prevedel-embl/ECG-gating/FPGA/Original codes/Matlab/index.jpg

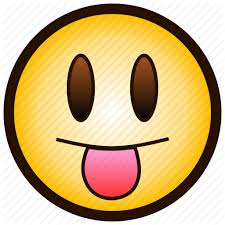
FPGA/Original codes/Matlab/index.jpg
