prevedel-embl/ECG-gating/FPGA/Demonstration/readme.txt

This is a demo file which can be copied into a microSD card for FPGA.
