prevedel-embl/ECG-gating/FPGA/pdf/Schematic of FPGA-board based ECG-gating system.pdf

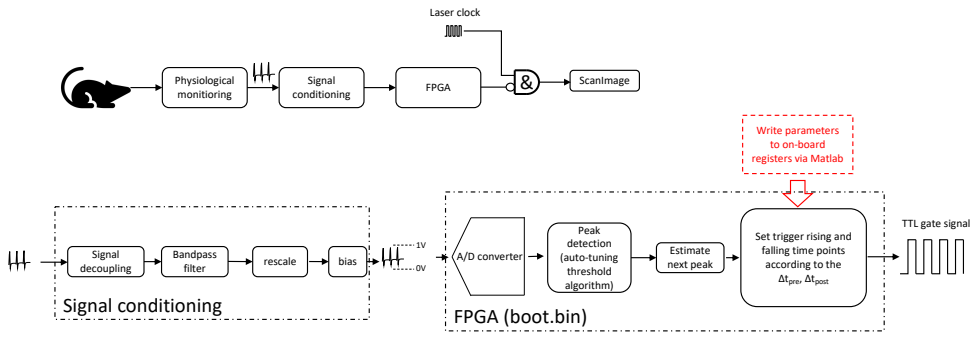
[picture p2: page 1]
Physiological monitioring; Signal; conditioning; FPGA; ScanImage; Laser clock; Bandpass; filter; rescale; bias; A/D converter; Peak detection (auto-tuning threshold algorithm); Estimate next peak; Signal decoupling Signal conditioning

Write parameters
to on-board
registers via Matlab

TTL gate signal

Set trigger rising and
falling time points
according to the
∆tpre, ∆tpost

FPGA (boot.bin)
